phirom-hue/CDPR-For-Irrigation/README.md

https://youtu.be/ENY-hU8YfIg

# Cable Driven Parallel Robot For Irrigation
